Jdban/jdb-cad/ice-maker/photos/i3-no-arm-stops-short.jpg

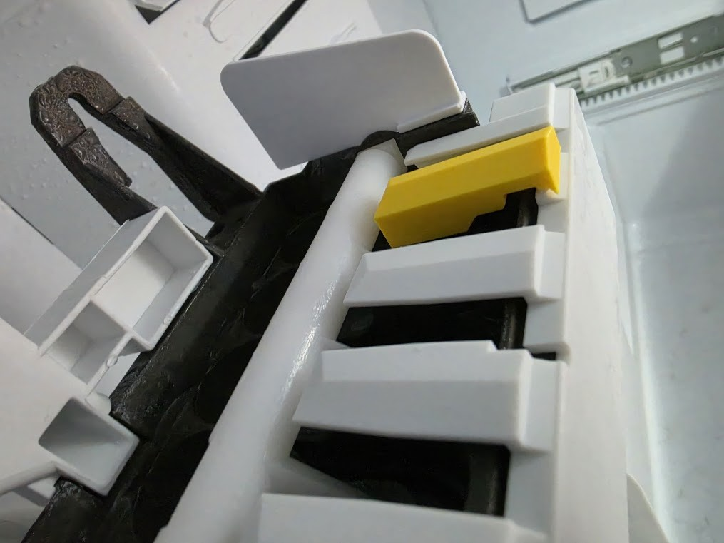
ice-maker/photos/i3-no-arm-stops-short.jpg
