Jdban/jdb-cad/ice-maker/photos/i5-installed_labeled.jpg

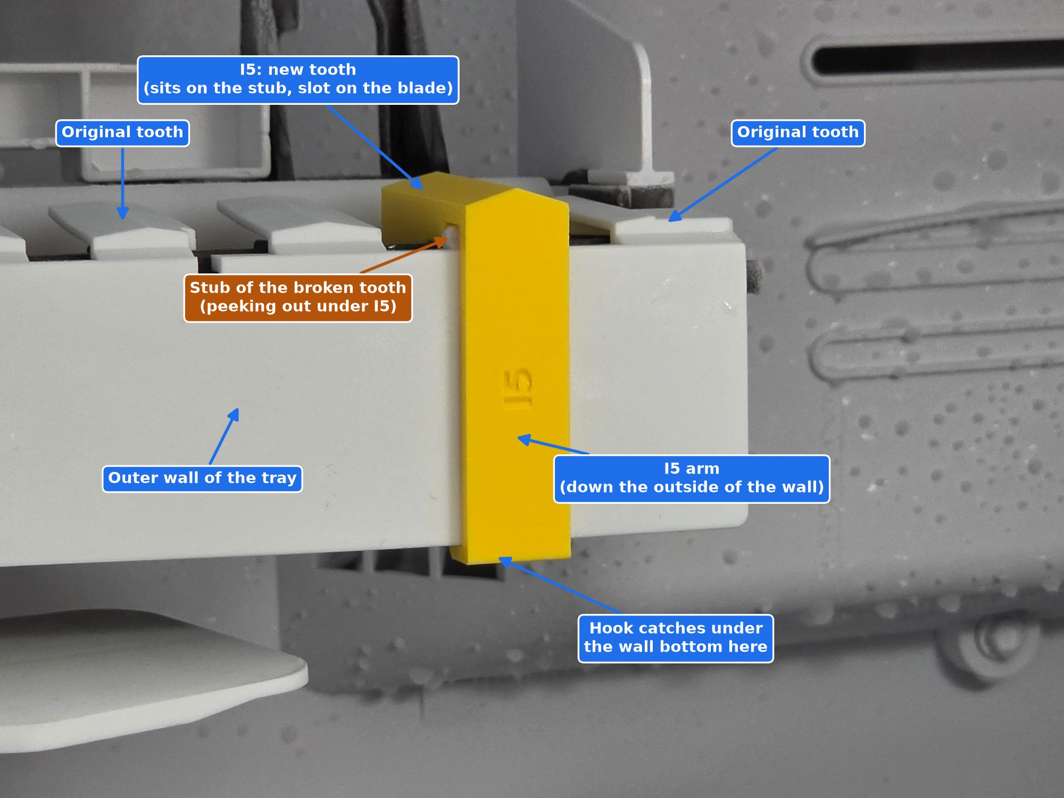
ice-maker/photos/i5-installed_labeled.jpg
