Jdban/jdb-cad/requirements-lock.txt

# Full environment snapshot (uv pip freeze). Exact reproduction: uv pip install -r requirements-lock.txt
anytree==2.13.0
asttokens==3.0.2
bd-materials==0.2.5
bd-warehouse==0.4.0
build123d==0.13.0
cadquery-ocp-novtk==8.0.1.1.0
cadquery-ocp-proxy==8.0.1.1.0
certifi==2026.10.23
charset-normalizer==3.5.2
cloudpickle==3.1.2
contourpy==1.4.0
cycler==0.12.1
dataclasses-json==0.6.7
deprecated==3.0.1
executing==2.3.0
ezdxf==1.4.5
fonttools==4.68.0
idna==3.20
ipython==9.18.1
ipython-pygments-lexers==1.1.1
jedi==0.20.1
joblib==1.6.0
kiwisolver==1.5.1
lib3mf==2.5.0
manifold3d==3.5.4
marshmallow==3.26.2
matplotlib==3.11.2
matplotlib-inline==0.2.2
mpmath==1.3.0
mypy-extensions==1.2.0
narwhals==2.28.0
networkx==3.7
numpy==2.5.4
ocp-gordon==0.3.1
ocpsvg==0.7.0
packaging==26.3
parso==0.8.7
pexpect==4.9.0
pillow==13.0.0
platformdirs==4.14.5
prompt-toolkit==3.0.53
psutil==7.2.2
ptyprocess==0.7.0
pure-eval==0.2.4
pygltflib==1.16.5
pygments==2.21.0
pyparsing==3.3.3
python-dateutil==4.0.0
requests==2.34.2
rtree==1.4.1
scikit-learn==1.9.1
scipy==1.18.1
shapely==2.2.0
stack-data==0.6.3
svgelements==1.9.6
svgpathtools==1.8.0
svgwrite==1.4.3
sympy==1.14.0
threadpoolctl==3.8.0
threejs-materials==1.2.5
traitlets==5.16.1
trianglesolver==1.2
trimesh==5.2.0
typing-extensions==4.16.0
typing-inspect==0.9.0
tzdata==2026.6
urllib3==2.8.0
wcwidth==0.9.4
webcolors==24.8.0
wrapt==2.5.2
