Jdban/jdb-cad/ice-maker/original/Ice Maker Fix JDB.stl

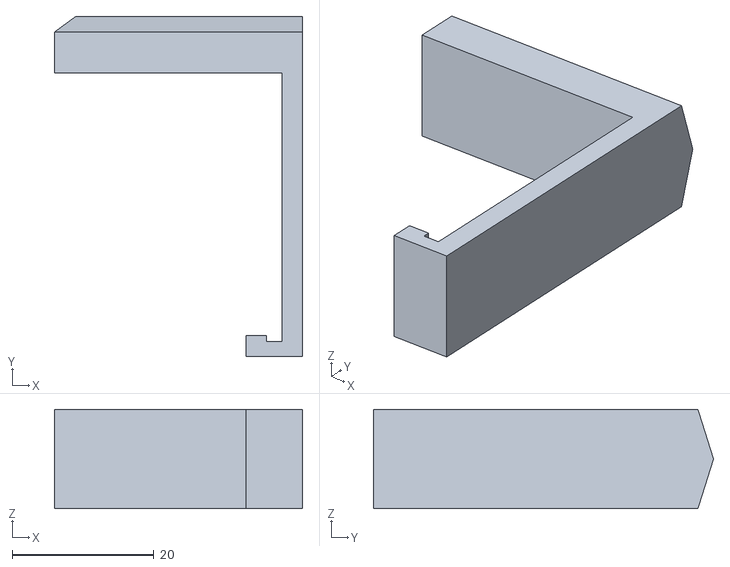
[picture p3: CAD file, 2026-11-09]
ice-maker/original/Ice Maker Fix JDB.stl
35.0 x 48.0 x 14.0
