Jdban/jdb-cad/ice-maker/out/I2_print.3mf

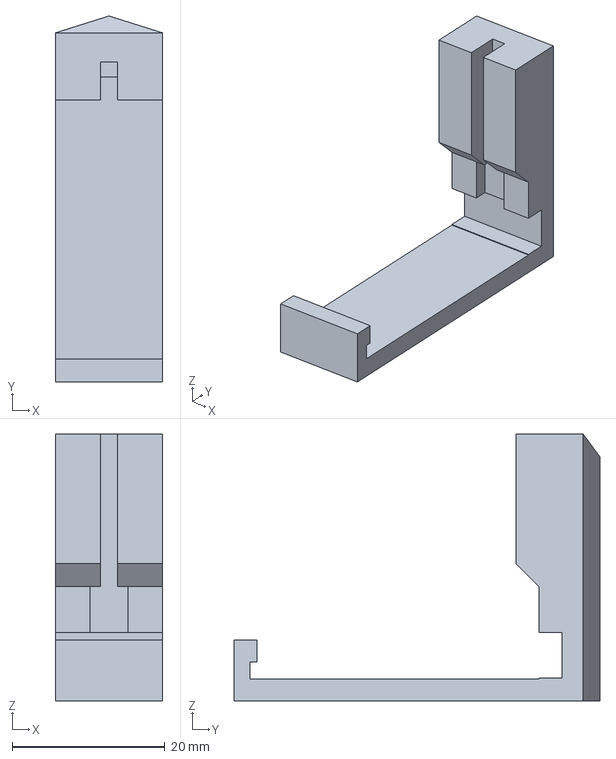
[picture p4: CAD file, 2026-11-09]
ice-maker/out/I2_print.3mf
14.0 x 48.0 x 35.0 mm
