Jdban/jdb-cad/ice-maker/out/I3.step

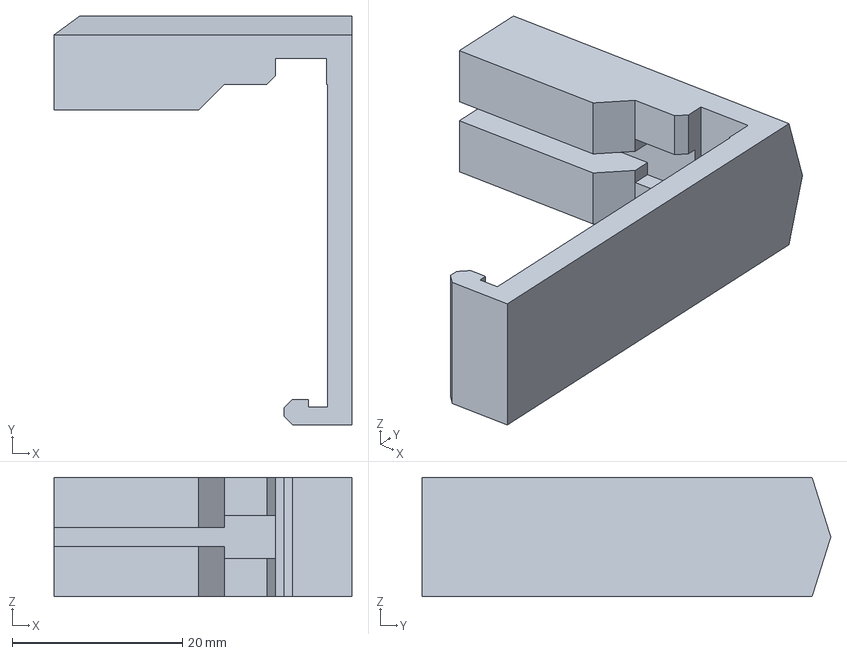
[picture p5: CAD file, 2026-11-09]
ice-maker/out/I3.step
35.0 x 48.0 x 14.0 mm
