Jdban/jdb-cad/ice-maker/out/test-K_print.3mf

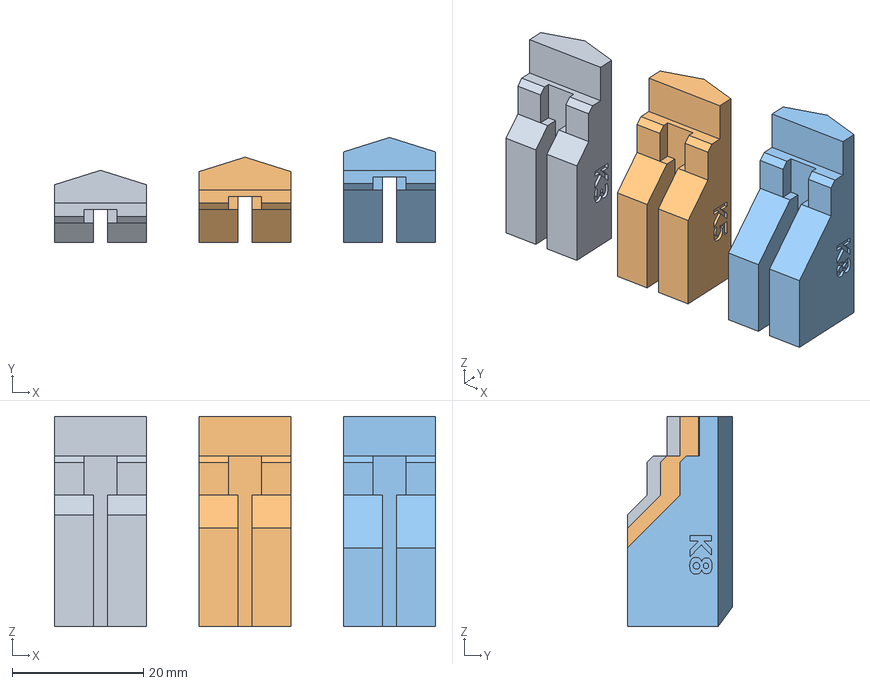
[picture p6: CAD file, 2026-11-09]
ice-maker/out/test-K_print.3mf
58.0 x 16.0 x 32.0 mm
