Jdban/jdb-cad/ice-maker/out/I5.step

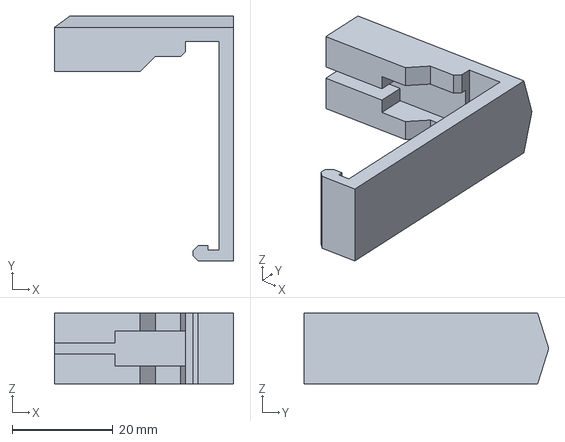
[picture p7: CAD file, 2026-11-09]
ice-maker/out/I5.step
35.5 x 48.5 x 14.0 mm
