Jdban/jdb-cad/ice-maker/out/test-N_print.3mf

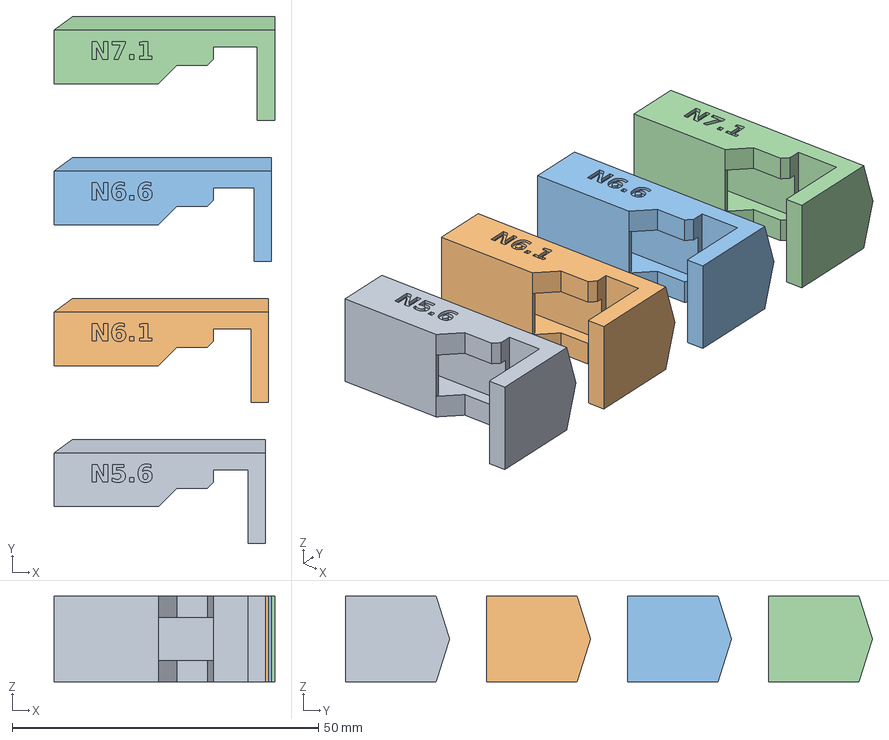
[picture p8: CAD file, 2026-11-09]
ice-maker/out/test-N_print.3mf
36.0 x 86.0 x 14.0 mm
