Jdban/jdb-cad/ice-maker/out/I5_print.3mf

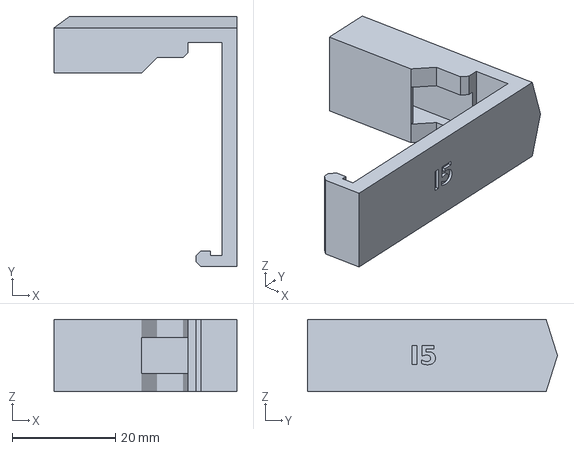
[picture p9: CAD file, 2026-11-09]
ice-maker/out/I5_print.3mf
35.5 x 48.5 x 14.0 mm
