Jdban/jdb-cad/ice-maker/out/I1_print.3mf

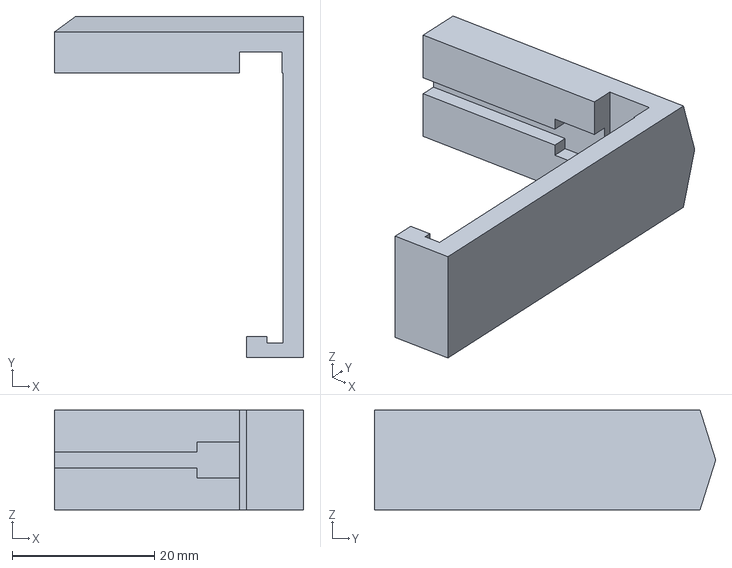
[picture p10: CAD file, 2026-11-09]
ice-maker/out/I1_print.3mf
35.0 x 48.0 x 14.0 mm
