Jdban/jdb-cad/ice-maker/out/test-EW_print.3mf

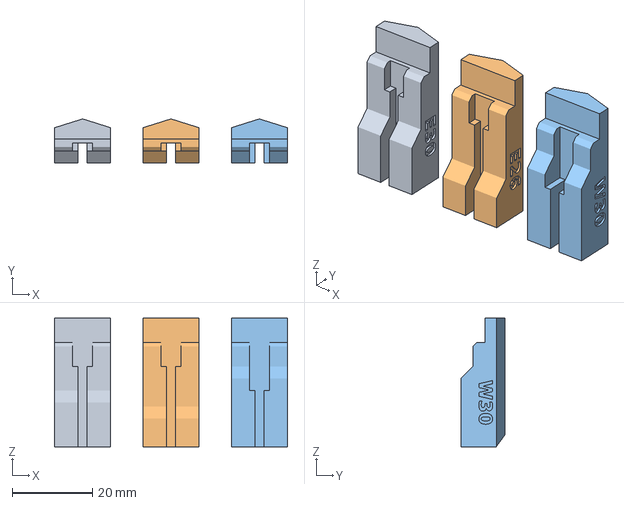
[picture p11: CAD file, 2026-11-09]
ice-maker/out/test-EW_print.3mf
58.0 x 11.0 x 32.0 mm
