Jdban/jdb-cad/ice-maker/older-versions/Ice Maker Fix JDB.stl

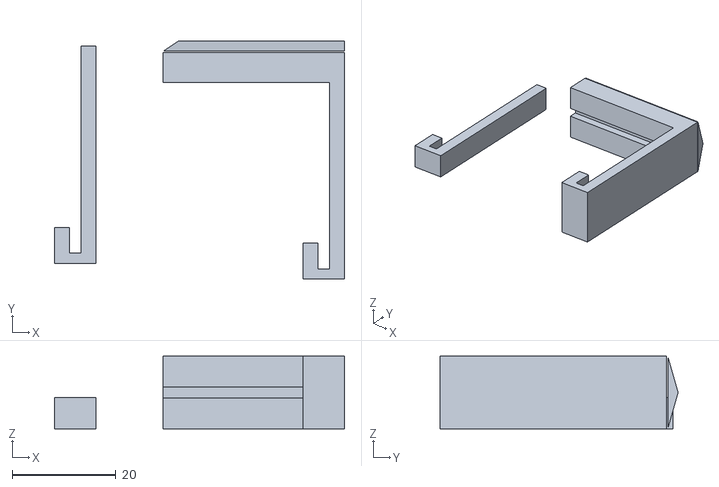
[picture p12: CAD file, 2026-11-09, an earlier design]
ice-maker/older-versions/Ice Maker Fix JDB.stl
56.0 x 46.0 x 14.0
