Jdban/jdb-cad/ice-maker/older-versions/Ice Maker Fix JDB (3).stl

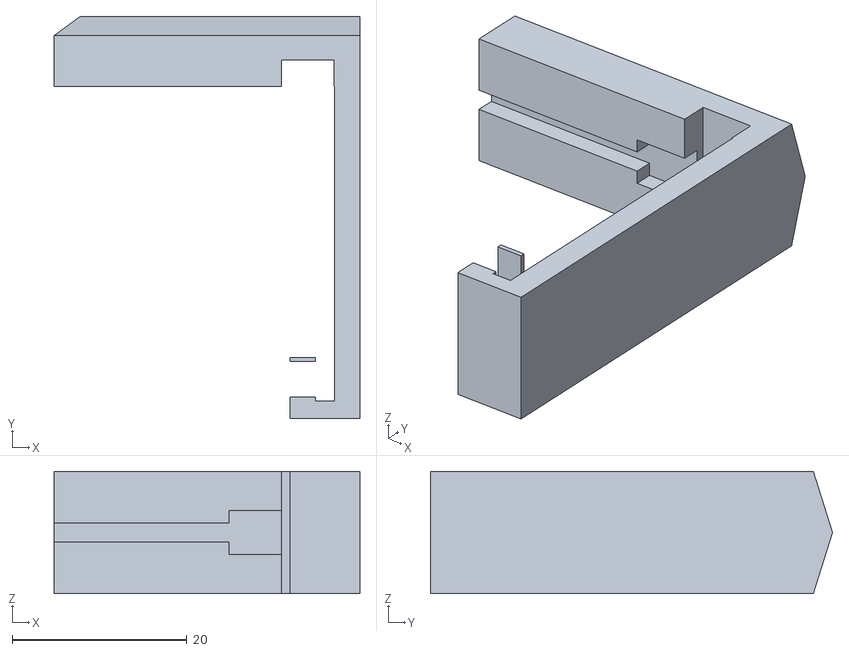
[picture p13: CAD file, 2026-11-09, an earlier design]
ice-maker/older-versions/Ice Maker Fix JDB (3).stl
35.0 x 46.0 x 14.0
