Jdban/jdb-cad/ice-maker/older-versions/JDB Ice Maker Bottom Exploration (1).stl

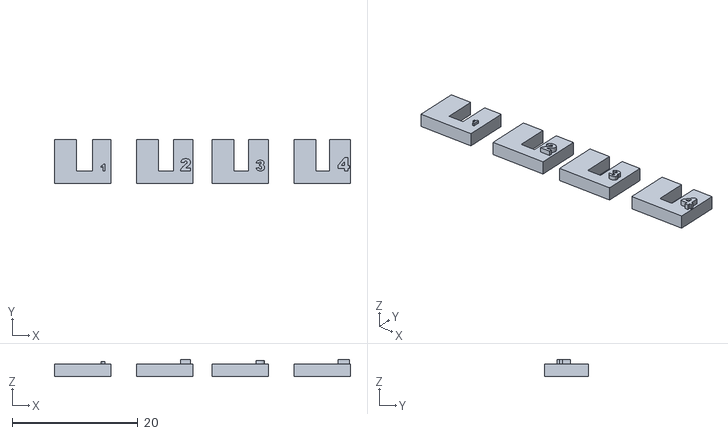
[picture p15: CAD file, 2026-11-09, an earlier design]
ice-maker/older-versions/JDB Ice Maker Bottom Exploration (1).stl
47.0 x 7.00 x 2.76
