Jdban/jdb-cad/ice-maker/older-versions/JDB Ice Maker Bottom Exploration.stl

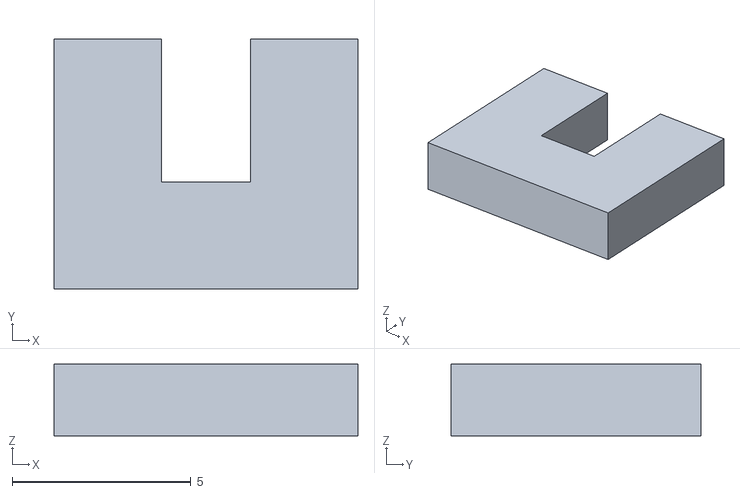
[picture p16: CAD file, 2026-11-09, an earlier design]
ice-maker/older-versions/JDB Ice Maker Bottom Exploration.stl
8.50 x 7.00 x 2.00
