Jdban/jdb-cad/(list of files, cad)

Other CAD files:
ice-maker/out/I3_print.3mf
ice-maker/out/I2.step
ice-maker/out/I1.stl
ice-maker/older-versions/Ice Maker Fix JDB (1).stl
ice-maker/older-versions/Ice Maker Fix JDB (4).stl
ice-maker/out/I1_print.stl
ice-maker/out/I2.stl
ice-maker/out/I2_print.stl
ice-maker/out/I3.stl
ice-maker/out/I3_print.stl
ice-maker/out/I5.stl
ice-maker/out/I5_print.stl
ice-maker/out/test-EW_print.stl
ice-maker/out/test-K_print.stl
ice-maker/out/test-N_print.stl
