Jdban/jdb-cad/ice-maker/photos/arm-compare.png

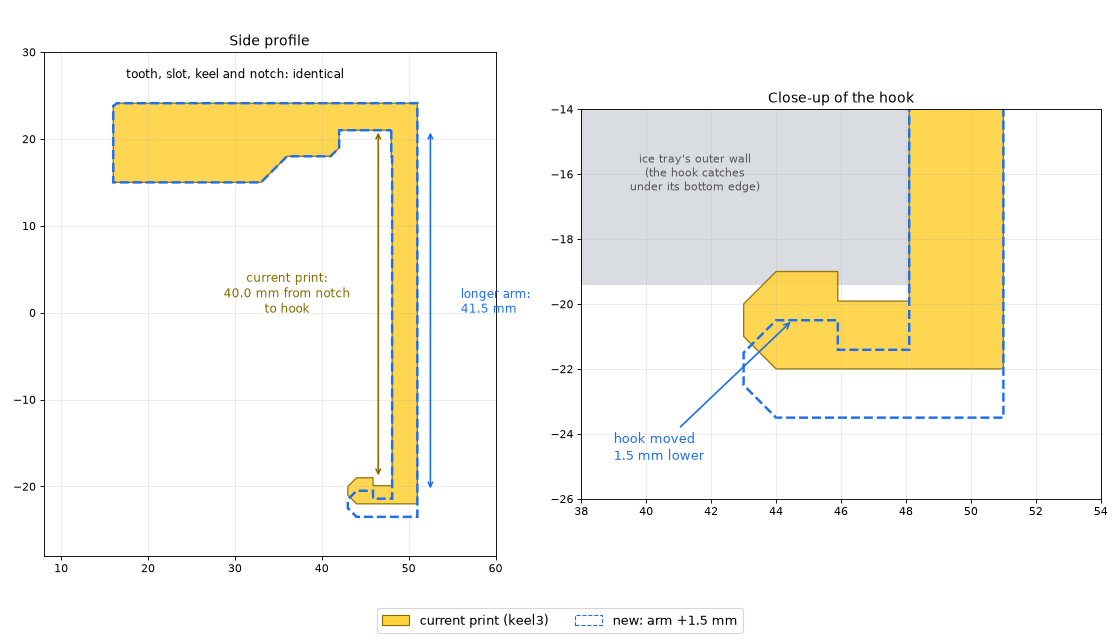
ice-maker/photos/arm-compare.png
