Jdban/jdb-cad/ice-maker/photos/i2-snapped-here.png

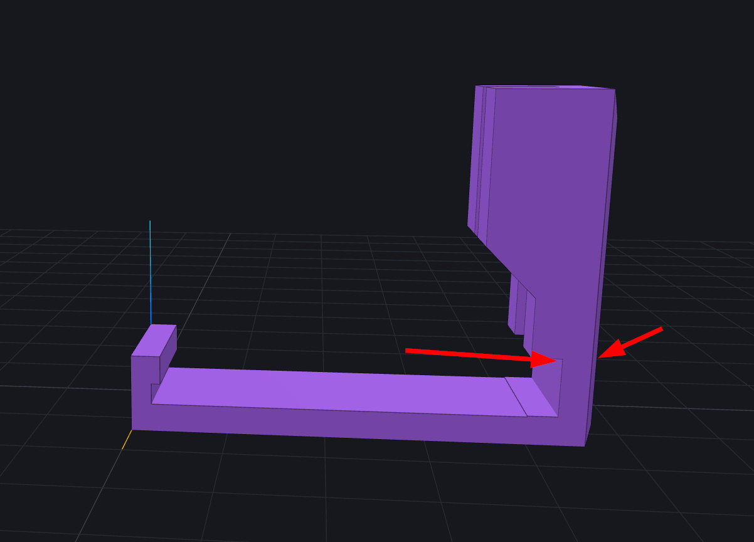
ice-maker/photos/i2-snapped-here.png
