Jdban/jdb-cad/ice-maker/photos/i3-installed-with-arm.jpg

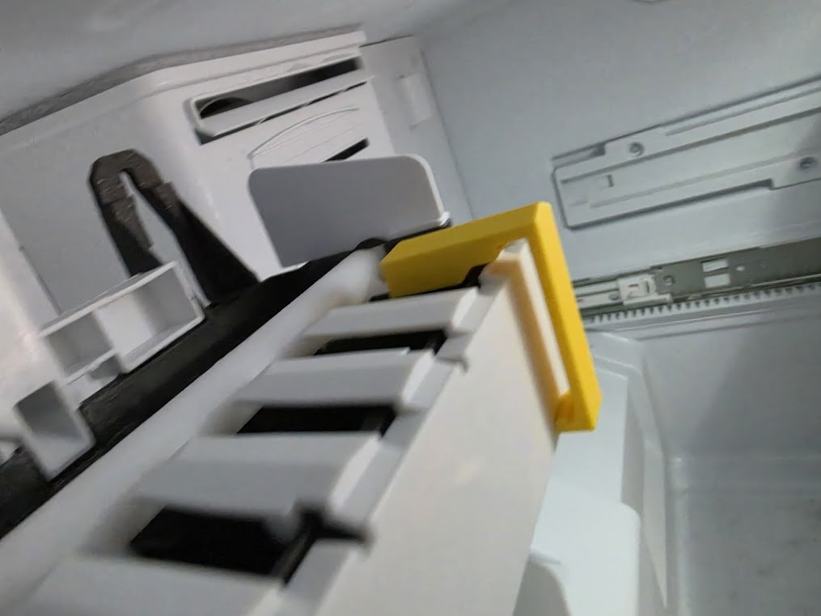
ice-maker/photos/i3-installed-with-arm.jpg
