Jdban/jdb-cad/ice-maker/photos/i5-diagram.png

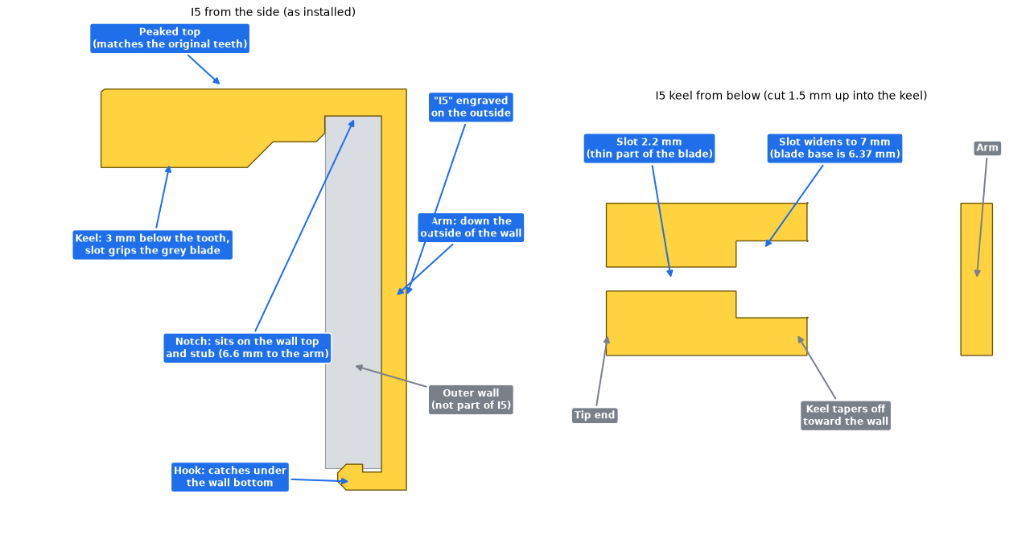
ice-maker/photos/i5-diagram.png
