Jdban/jdb-cad/ice-maker/photos/i5-installed.jpg

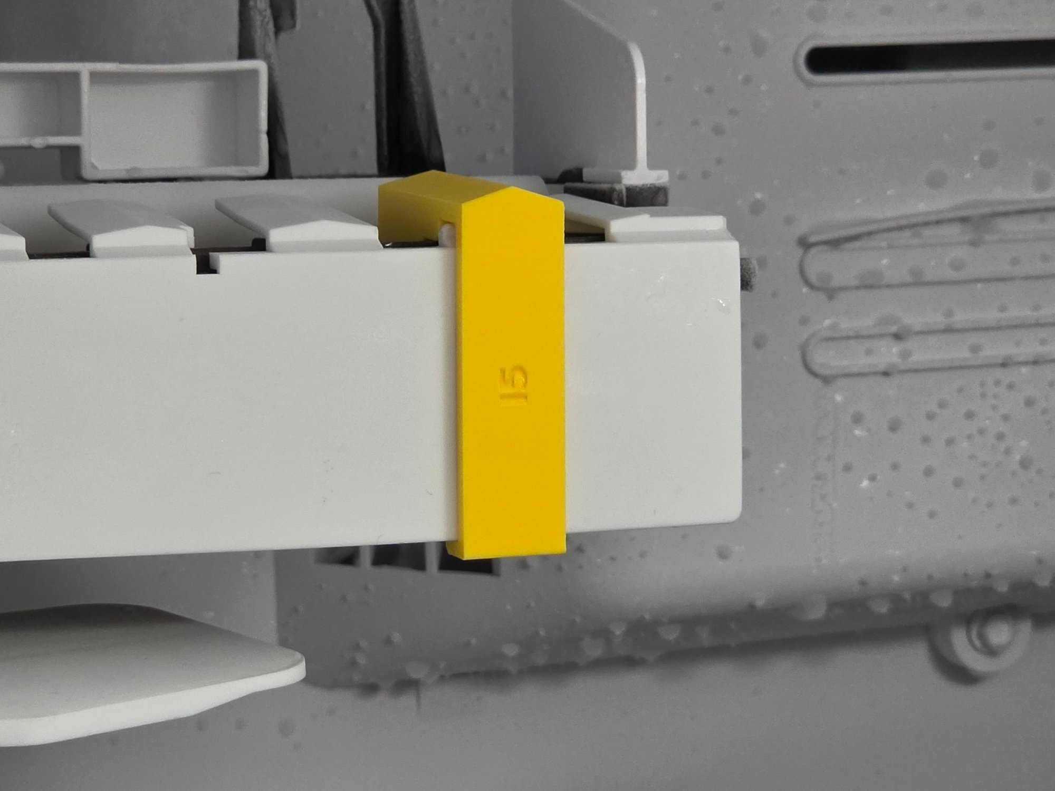
ice-maker/photos/i5-installed.jpg
