Jdban/jdb-cad/ice-maker/photos/stripper-top-view.jpg

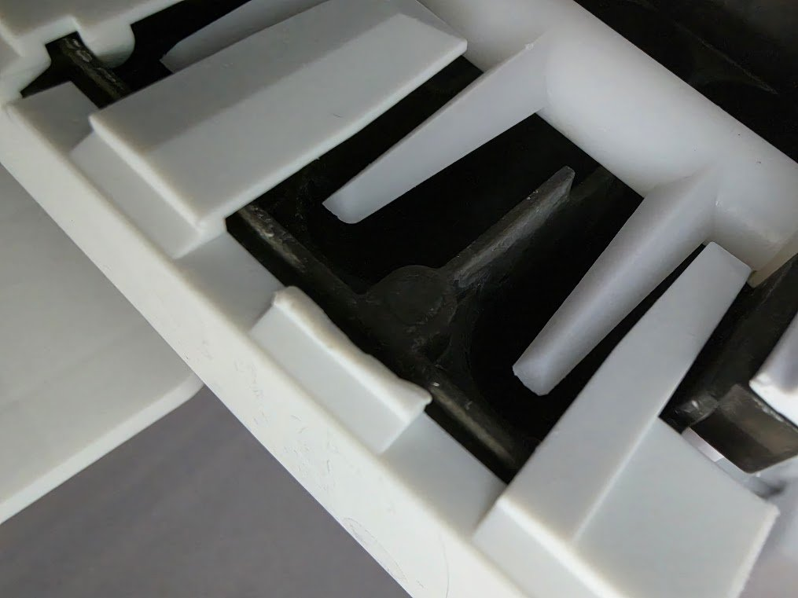
ice-maker/photos/stripper-top-view.jpg
