Jdban/jdb-cad/ice-maker/photos/stripper-top-view_labeled.jpg

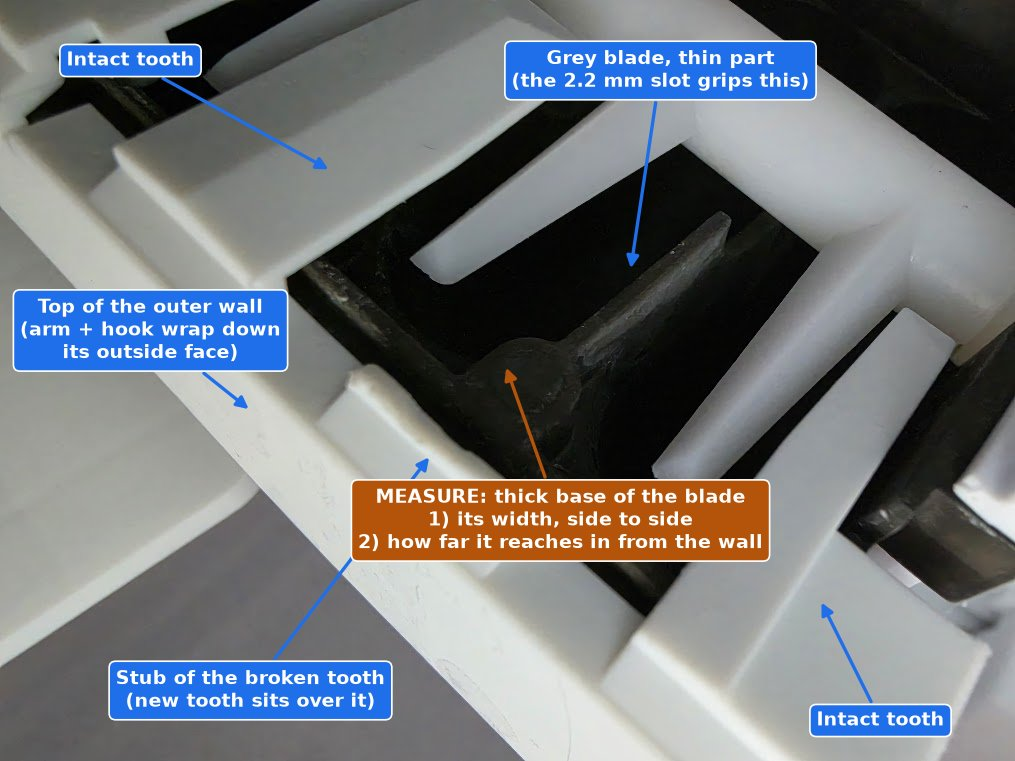
ice-maker/photos/stripper-top-view_labeled.jpg
