Jdban/jdb-cad/(commit log)

2026-11-09 Parametric 3D-printing workflow with ice maker example
    Agent instructions (AGENT.md), a local three.js model viewer with print
    settings cards, overhang shading, section and measure tools, helper scripts
    to compare rebuilds against originals, check printability and render views,
    a minimal example part, and the ice maker stripper tooth as a worked example
    (rebuild of the original, keel design, and a K3/K5/K8 fit-test set).
    [Ice Maker Fix JDB (1).stl, Ice Maker Fix JDB (2).stl, Ice Maker Fix JDB (3).stl, Ice Maker Fix JDB (4).stl, Ice Maker Fix JDB.stl, JDB Ice Maker Bottom Exploration (1).stl, JDB Ice Maker Bottom Exploration.stl, ice-tooth_fit-test-set_print.3mf]
2026-11-09 Ice maker: conservative 3 mm keel tooth and --keel depth option
    [ice-tooth_keel3.step, ice-tooth_keel3.stl, ice-tooth_keel3_print.3mf, ice-tooth_keel3_print.stl]
2026-11-09 Viewer: self-reload on page changes, explode slider with per-part offsets, fixed colours from sidecars, assembled view from focus
2026-11-09 Viewer: explode/assemble toggle button
2026-11-09 Ice maker: print flat with sacrificial slot skin, lead-in chamfers (standing print snapped at the neck)
    [ice-tooth_fit-test-set_print.3mf, ice-tooth_fit-test-set_print.stl, ice-tooth_keel.step, ice-tooth_keel.stl, ice-tooth_keel3.step, ice-tooth_keel3.stl, ice-tooth_keel3_print.3mf, ice-tooth_keel3_print.stl]
2026-11-09 Ice maker: --arm-extra option and a 1.5 mm longer arm variant (too tight to snap on)
    [ice-tooth_keel3_arm+1.5.step, ice-tooth_keel3_arm+1.5.stl, ice-tooth_keel3_arm+1.5_print.3mf, ice-tooth_keel3_arm+1.5_print.stl]
2026-11-09 Ice maker: wall-end fit test (keel end / widened slot near the hub)
    [ice-tooth_wall-fit-test_print.3mf, ice-tooth_wall-fit-test_print.stl]
2026-11-09 Ice maker: test labels run along the tooth (fit on shallow keels), draft settings for fit tests
    [ice-tooth_fit-test-set_print.3mf, ice-tooth_fit-test-set_print.stl, ice-tooth_keel.step, ice-tooth_keel_print.3mf, ice-tooth_wall-fit-test_print.3mf, ice-tooth_wall-fit-test_print.stl]
2026-11-09 Ice maker: W30 won the wall-end test; W6/W7/W8 wide-slot fit test
    [ice-tooth_wide-fit-test_print.3mf, ice-tooth_wide-fit-test_print.stl]
2026-11-09 Ice maker: I4 (W7 slot from measured 6.37 mm blade base, arm +0.5, engraved ID, wide skin)
    [ice-tooth_I4.step, ice-tooth_I4.stl, ice-tooth_I4_print.3mf, ice-tooth_I4_print.stl]
2026-11-09 Ice maker: notch-length fit test (arm position), set_arm_shift
    [ice-tooth_notch-fit-test_print.3mf, ice-tooth_notch-fit-test_print.stl]
2026-11-09 Ice maker: notch runs flush into the arm (remove inherited 0.1 mm step)
    [ice-tooth_I4.step, ice-tooth_I4.stl, ice-tooth_I4_print.3mf, ice-tooth_I4_print.stl, ice-tooth_notch-fit-test_print.3mf, ice-tooth_notch-fit-test_print.stl]
2026-11-09 Ice maker: I5 (notch 6.6 from the N6.6 fit test)
    [ice-tooth_I5.step, ice-tooth_I5.stl, ice-tooth_I5_print.3mf, ice-tooth_I5_print.stl]
2026-11-09 Default to slicer supports instead of a sacrificial slot skin (user preference)
2026-11-09 Ice maker tracker: watch I5, finger-clearance photo for possible stub skirts
2026-11-09 Restructure part scripts around frozen versions and shared helpers
    Part dimensions now live in one frozen dataclass per part, with versions and
    fit-test plates defined as named variations instead of command-line flags that
    mutated module globals. A shared kit (tools/kit.py) handles export, plate
    layout, generated settings cards, a parameter record per build, and freezing:
    once a part is printed its files are the record of that print and are not
    overwritten. Every printed ice maker part (I1-I5, test-K/EW/N) and the
    changing table parts were verified to rebuild exactly from the new scripts.
    Also: regression check (tools/regress.py), new-project template
    (tools/new_project.sh from examples/bra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
    [I1.stl, I1_print.3mf, I1_print.stl, I2.step, I2.stl, I2_print.3mf, I2_print.stl, I3.step]
2026-11-11 Run the toolchain and viewer in Docker
    One image (jdb-cad) holds Python, build123d, trimesh and the DejaVu font that
    engraved IDs depend on. compose.yaml runs the viewer with the repo mounted
    read-only, published on localhost only; tools/cad runs any script in the
    container as the calling user. The server's bind address and extra allowed
    host names are now settings, for running it behind an auth proxy later.
2026-11-12 Viewer: open 3MF files, and drop a model file onto the page to view it
    Standalone .3mf files (downloads, slicer projects) are listed and load like
    STL; a .3mf that sits next to a same-named .stl (every print export) is not
    listed twice. Dropping a .stl/.3mf/.obj onto the 3D view reads it in the
    browser only: nothing is uploaded and the server stays read-only.
    Also fixes /?show=... links (the tracker's view chips) returning a
    directory listing instead of the viewer.
2026-11-12 Tracker: inbox for sending files and a note from the browser
    An upload box on the tracker page saves files into inbox/<date_time_id>/,
    with the note as note.txt. This is the only thing the server writes: uploads
    must come from the page itself (matching Origin plus a custom header, so other
    websites can't post to it), names are reduced to plain file names with an
    allowed extension, nothing is overwritten, and in Docker only inbox/ is
    mounted writable. The inbox contents are private (gitignored).
